ReinhardLenz/GyroVisor/images/circuit_image1.png

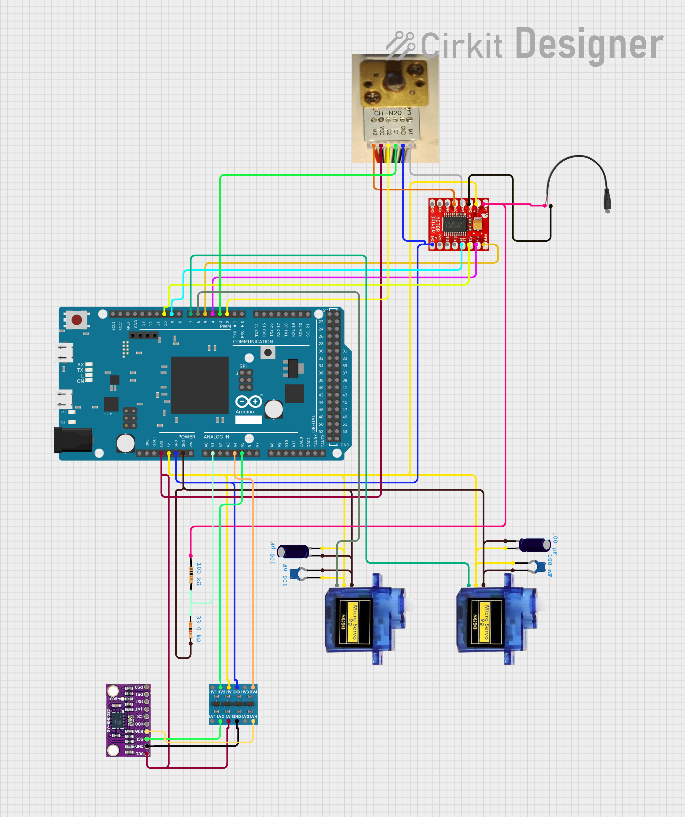
images/circuit_image1.png
