ReinhardLenz/GyroVisor/images/circuit_image_Seeeduino_XIAO.png

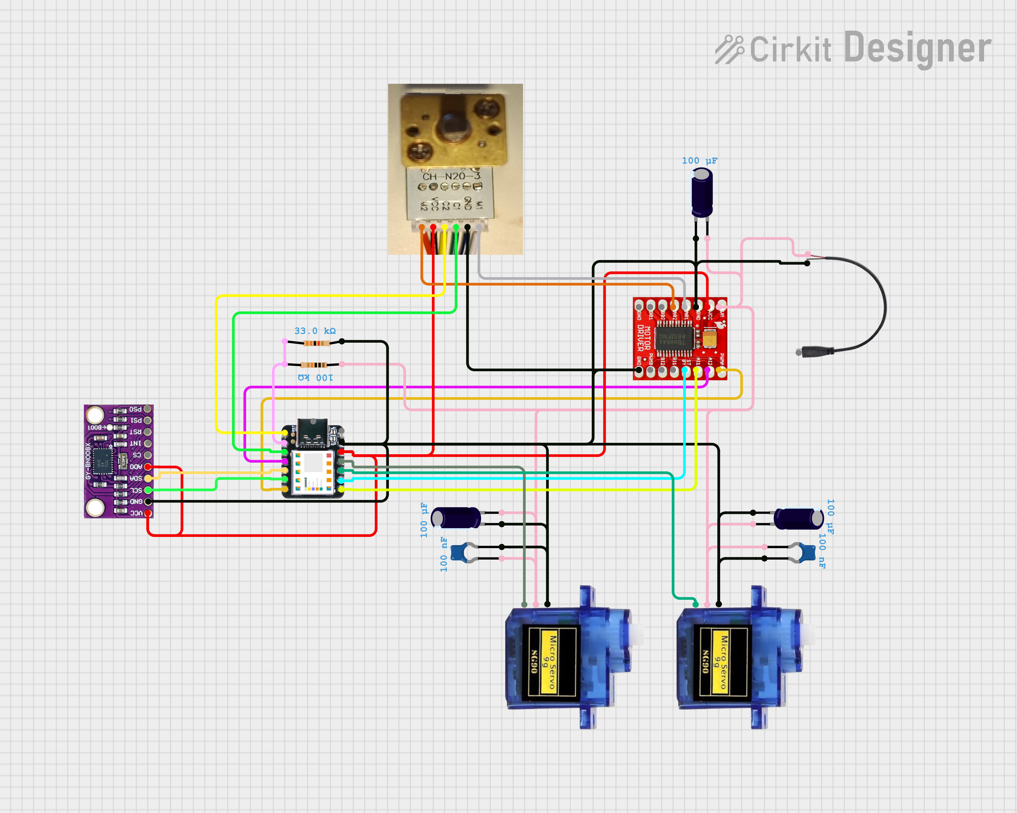
images/circuit_image_Seeeduino_XIAO.png
