ReinhardLenz/GyroVisor/images/error_time_protocol.png

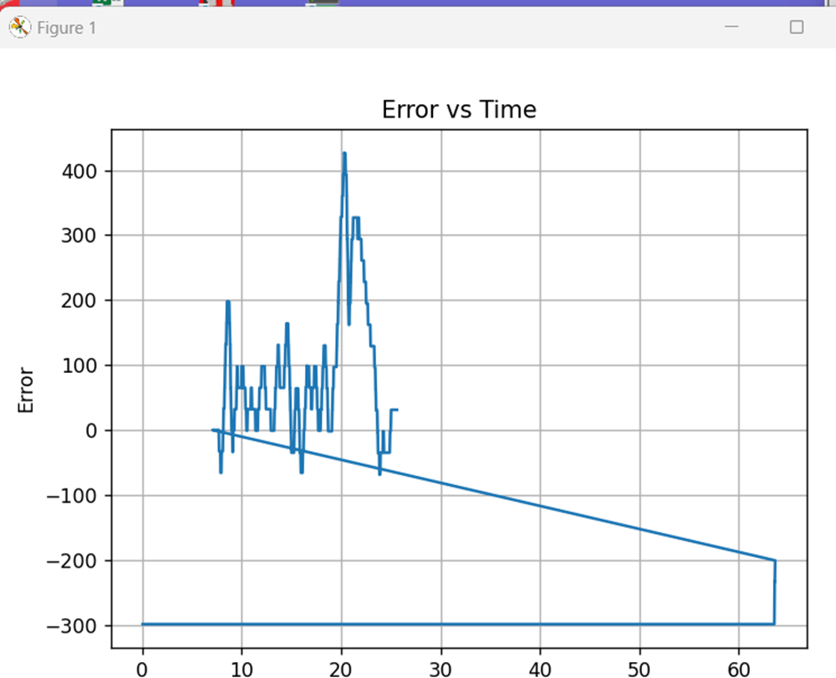
images/error_time_protocol.png
