ReinhardLenz/GyroVisor/images/photo_BNO085_gyrovisor.jpg

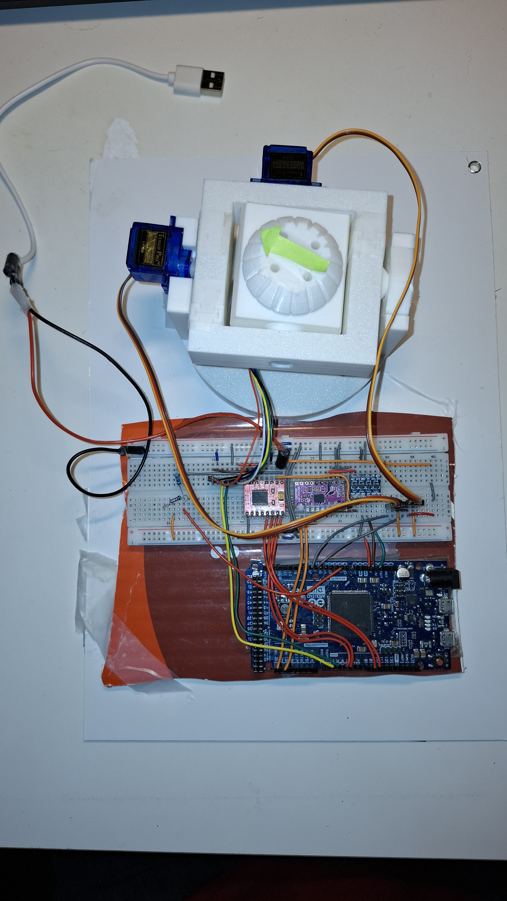
images/photo_BNO085_gyrovisor.jpg
