ReinhardLenz/GyroVisor/measure_error_time_protocol_2nd.txt

t=59.44s error=-2039.0
t=59.44s error=-2030.0
t=59.45s error=-2011.0
t=59.48s error=-2048.0
t=59.49s error=-2039.0
t=59.49s error=-2029.0
t=59.52s error=-2105.0
t=59.53s error=-2096.0
t=59.53s error=-2086.0
t=59.55s error=-2065.0
t=59.58s error=-2100.0
t=59.59s error=-2090.0
t=59.59s error=-2081.0
t=59.60s error=-2062.0
t=59.63s error=-2097.0
t=59.64s error=-2087.0
t=59.64s error=-2077.0
t=59.67s error=-2153.0
t=59.68s error=-2143.0
t=59.69s error=-2133.0
t=59.69s error=-2113.0
t=59.73s error=-2182.0
t=59.73s error=-2172.0
t=59.74s error=-2162.0
t=59.75s error=-2143.0
t=59.78s error=-2212.0
t=59.79s error=-2202.0
t=59.79s error=-2193.0
t=59.82s error=-2266.0
t=59.83s error=-2257.0
t=59.83s error=-2246.0
t=59.84s error=-2226.0
t=59.88s error=-2291.0
t=59.88s error=-2281.0
t=59.89s error=-2271.0
t=59.90s error=-2249.0
t=59.93s error=-2280.0
t=59.94s error=-2269.0
t=59.94s error=-2259.0
t=59.95s error=-2237.0
t=59.98s error=-2264.0
t=59.99s error=-2253.0
t=59.99s error=-2243.0
t=60.03s error=-2313.0
t=60.03s error=-2303.0
t=60.04s error=-2292.0
t=60.05s error=-2270.0
t=60.08s error=-2299.0
t=60.09s error=-2289.0
t=60.09s error=-2278.0
t=60.10s error=-2256.0
t=60.13s error=-2319.0
t=60.14s error=-2309.0
t=60.14s error=-2298.0
t=60.17s error=-2367.0
t=60.18s error=-2356.0
t=60.18s error=-2345.0
t=60.20s error=-2321.0
t=60.23s error=-2380.0
t=60.23s error=-2370.0
t=60.24s error=-2358.0
t=60.25s error=-2334.0
t=60.28s error=-2392.0
t=60.29s error=-2381.0
t=60.29s error=-2370.0
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
t=72.02s error=326.0
t=72.06s error=320.0
t=72.06s error=319.0
t=72.06s error=319.0
t=72.07s error=318.0
t=72.10s error=313.0
t=72.11s error=312.0
t=72.11s error=312.0
t=72.11s error=312.0
t=72.13s error=311.0
t=72.16s error=307.0
Stopped.

Integral of Absolute Error (IAE): 83891.95
