ReinhardLenz/GyroVisor/src/main.cpp

#include <Arduino.h>
#include <SparkFun_BNO08x_Arduino_Library.h>
#include <Encoder.h>
#include "Compass.h"
#include <Wire.h>
#include <Servo.h>

#define BNO08X_RESET -1
#define TIMEOUT_BOOT_BNO 100
#define BNO08X_I2C_ADDRESS 0x4B

//const int alwaysOnButtonPin = A0;
unsigned long millisOld;
const unsigned long vibrationDurationMillis = 200UL;
const unsigned long vibrationIntervalMillis = 1000UL;
const unsigned long serialKeepDurationMillis = 10UL * 1000UL;


//const int PIN_SDA = A4;   // works on many cores; otherwise set explicit pin numbers
//const int PIN_SCL = A5;

static uint32_t lastGoodEventMs = 0;
static uint32_t bootMs = 0;
static uint32_t lastRecoverAttemptMs = 0;

// Tune these:
const uint32_t STARTUP_GRACE_MS = 3000;          // wait after setup before any recovery
const uint32_t NO_EVENT_BEFORE_RECOVER_MS = 4000; // must be "dead" this long before recovery
const uint32_t RECOVER_COOLDOWN_MS = 5000;        // minimum time between recovery attempts

int degree_shift;
long lastSerialRecv = -10000L;
float lastSerialHeading = 0.0f;


Compass compass;
BNO08x imu;

#define DBG_PRINTLN(x) do { if (Serial) Serial.println(x); } while(0)
#define DBG_PRINT(x)   do { if (Serial) Serial.print(x); } while(0)


// --------------------- TB6612 Motor Driver ---------------------
const int pwmA = 3; // pin for motor A PWM speed control
const int in1A = 10; // pin for motor AI1 direction control
const int in2A = 9; // pin for motor AI2 direction control
const int stby = 0; // pin for motor driver standby (active HIGH)
const int Servo_pitch = 6; // pin for servo control
const int Servo_roll = 7; // pin for servo control



// --------------------- VM Sensing ---------------------
#define VM_SENSE 8  // ADC pin for sensing motor supply voltage (VM). Connect a voltage divider from VM to this pin, with the midpoint going to the ADC pin and the bottom resistor to GND. The top resistor goes to VM. For example, a 56kΩ bottom resistor and 100kΩ top resistor gives a ~1.785 divider, so 12V on VM would read about 6.7V at the ADC pin, which is above the 5V max ADC input but we will just treat it as "over threshold". Adjust the threshold accordingly.
//const float VM_DIVIDER = 1.785;   // 100k / 56k divider
const float VM_THRESHOLD = 4.9;  // volts

// --------------------- Encoder ---------------------
//Encoder enc(1, 2); // pins for encoder input (A, B)

// --------------------- Control Parameters ---------------------
const int DEADZONE = 100;   // encoder counts tolerance
const long SCALE_DEG_TO_ENC = 33L;  
// ~12 counts per pot unit = ~12000 counts full-scale for 1023 pot units.
// 12000 counts / 360° ≈ 33 counts per degree.

// --------------------- Compass ---------------------
float heading = 0.0;
float roll = 0.0;
float pitch= 0.0;
// --------------------- Runtime Variables ---------------------
long targetEnc = 0;
long currentEnc = 0;
long error = 0;
float lastHeading = 0.0;
float continuousHeading = 0.0;

Servo servo_pitch;
Servo servo_roll;

float prevRoll = 0.0f;
float prevPitch = 0.0f;
static unsigned long lastServo = 0;

//PID control  variables
float Kd = 0.00;
const float Kp = 0.02;     // proportional gain

// PID state variables
float integral = 0;
float lastError = 0;
unsigned long lastTime = 0;
const int MIN_PWM = 40; 

static uint32_t lastEncoderChange = 0;
static long prevEnc = 0;


// --------------------- Helper Functions ---------------------
float readVmVoltage() {
  int raw = analogRead(VM_SENSE);
  float vin = raw * (5.0 / 1023.0);
  return vin;
}


volatile long encoderCount = 0;

const int encoderA = 1;
const int encoderB = 2;

void encoderISR() {

    if (digitalRead(encoderB))
        encoderCount++;
    else
        encoderCount--;
}


// Simple function to blink the built-in LED n times (for error indication)
void blinkCode(int n) {
  for (int i = 0; i < n; i++) {
    digitalWrite(LED_BUILTIN, HIGH); delay(150);
    digitalWrite(LED_BUILTIN, LOW);  delay(150);
  }
  delay(600);
}


// --------------------- Setup ---------------------
void setup() {

  pinMode(LED_BUILTIN, OUTPUT);
  // Motor control pins
  pinMode(pwmA, OUTPUT);
  pinMode(in1A, OUTPUT);
  pinMode(in2A, OUTPUT);
  pinMode(stby, OUTPUT);
  digitalWrite(stby, LOW);
  //Servo initialization
  servo_pitch.attach(Servo_pitch);
  servo_roll.attach(Servo_roll);
  delay(2000);  // give bootloader time to enumerate
  
pinMode(encoderA, INPUT_PULLUP);
pinMode(encoderB, INPUT_PULLUP);

attachInterrupt(
    digitalPinToInterrupt(encoderA),
    encoderISR,
    RISING
);

  
  blinkCode(1);  // reached setup start
  Serial.begin(9600);
  blinkCode(2);  // reached setup start

  Wire.begin();
  blinkCode(3);  // reached setup start
  
  


  Wire.setClock(400000);
  delay(300);   // IMPORTANT: let BNO085 boot 
  // Initialize IMU

// Start communication with BNO085

  int retries = 0;
  while (!imu.begin() && retries < 10) {
    blinkCode(9); // IMU begin retry marker
    delay(500);
    retries++;
  }
  blinkCode(4);  // after imu.begin loop

  if (!imu.enableGameRotationVector(1000)) {
    blinkCode(7); // enable report failed
  } else {
    blinkCode(5); // enabled ok
  }
    delay(1000);
  }

// --------------------- Main Loop ---------------------
void loop() {
static bool t = false;
t = !t;
digitalWrite(LED_BUILTIN, t);

float vm = readVmVoltage();

if (vm > VM_THRESHOLD) {
  digitalWrite(stby, HIGH); // enable motor driver
  //    heading = compass.getHeading(degree_shift);   // 0–360°
  bool gotEvent = imu.getSensorEvent();
  if (gotEvent) {
    // Push the new event into Compass
    compass.updateFromSensor(imu.sensorValue);
    // Compute heading once for this event, using the latest degree_shift
    heading = compass.getHeading(degree_shift);
    lastGoodEventMs = millis();
  } else {
    // Optional 1s heartbeat
    static uint32_t lastPrintMs = 0;
    if (millis() - lastPrintMs > 1000) {
      //Serial.println("No sensor event (not necessarily an error)");
      lastPrintMs = millis();
      }
  }
  
  // --- Compute continuous heading to avoid 0°↔360° jumps ---
  float delta = heading - lastHeading;
  // Handle wrap-around crossing (e.g., 359° → 1° gives delta = -358°, fix it)
  if (delta > 180.0) delta -= 360.0;
  else if (delta < -180.0) delta += 360.0;
  continuousHeading += delta; //continuousHeading can grow beyond 0–360° (e.g. −720°, +1440°, etc.) It represents how much total rotation has occurred.
  // --- Convert continuous heading → target encoder counts ---
  targetEnc = (long)(continuousHeading * SCALE_DEG_TO_ENC); // also targetEnc can grow beyond 11880 or lelow -11880
//  DBG_PRINT("H:");
//  DBG_PRINT(targetEnc);

  static uint32_t lastEncRead = 0;

  currentEnc = encoderCount;
  
  // --- Compute control error ---
  error = targetEnc-currentEnc;

  long absErr = abs(error);

  // --- PID output ---
  unsigned long now = millis();
  float dt = (now - lastTime) / 1000.0;

  float derivative = 0;

  if (dt > 0)
      derivative = (error - lastError) / dt;

  float output = Kp * error + Kd * derivative;

  lastError = error;
  lastTime = now;



  // Convert to PWM
  int pwm = abs((int)output);
  

  
  if (absErr > 500 && pwm < MIN_PWM) {
    pwm = MIN_PWM;
  }

  if (pwm > 255) pwm = 255;
  // --- Control motor direction ---
  if (absErr <= DEADZONE) {  //if it is already close enough
    analogWrite(pwmA, 0); // stop motor
    digitalWrite(in1A, LOW);
    digitalWrite(in2A, LOW);
  } else if (output > 0) {     // moto
    digitalWrite(in1A, HIGH);
    digitalWrite(in2A, LOW);
    analogWrite(pwmA, pwm);

  } else {
    digitalWrite(in1A, LOW);
    digitalWrite(in2A, HIGH);
    analogWrite(pwmA, pwm);

  }

  } else {
    // VM below threshold → disable motor driver
    digitalWrite(stby, LOW);
    analogWrite(pwmA, 0);

}



if (millis() - lastServo > 20) {

  lastServo = millis();

  roll = compass.getRoll();
 servo_roll.write((int)(90 - roll));

  pitch = compass.getPitch();
  servo_pitch.write((int)(90 + pitch));
}



if (currentEnc != prevEnc) {
    lastEncoderChange = millis();
    prevEnc = currentEnc;
}

static long prevEnc = 0;

if (currentEnc != prevEnc) {
    lastEncoderChange = millis();
    prevEnc = currentEnc;
}

if (abs(error) > 2000 &&
    (int) (pwm) > 180 &&
    millis() - lastEncoderChange > 1000) {

    Serial.println("OUTPUT SYSTEM FROZEN");

    // full peripheral recovery
    servo_pitch.detach();
    servo_roll.detach();

    analogWrite(pwmA , 0);

    delay(50);

    servo_pitch.attach(Servo_pitch);
    servo_roll.attach(Servo_roll);

    analogWrite(pwmA, (int)(pwm));

    delay(50);
}


lastHeading = heading;
// heartbeat LED to indicate loop is alive 
digitalWrite(LED_BUILTIN, millis() % 1000 < 500);
}
