ReinhardLenz/GyroVisor/src/imu_visualizer.py

#from ursina import *
#from ursina import Ursina, color, Entity, DirectionalLight, Text, AmbientLight, EditorCamera, Vec3
from ursina import Ursina, color, Entity, DirectionalLight, Text, AmbientLight, EditorCamera, Vec3
from serial import Serial, SerialException
# Set up serial connection
try:
    serialPort = Serial(port="COM13", baudrate=9600, timeout=0.5)
except SerialException:
    print("Could not open serial port. Please check the port name and your permissions.")
    exit()
# Initialize the Ursina engine
app = Ursina()
app.background_color = color.rgb(0, 0, 255)  # Set background to blue
# Create a red cuboid
cuboid = Entity(
    model='cube',
    color=color.red,
    scale=(4, .5, 2)
)

LINE_LENGTH = 0.2
LINE_THICKNESS = 0.02
# Define the function to create a line entity
def create_line(length, thickness, color, position):
    return Entity(
        model='cube',
        scale=(length, thickness, thickness) if length > thickness else (thickness, length, thickness),
        color=color,
        position=position
    )

def setup_lighting():
    # Create a directional light
    directional_light = DirectionalLight()
    directional_light.look_at(Vec3(1, -1, -1))  # Direction the light is pointing towards
    directional_light.cast_shadow = True  # Enable casting shadows
    # Further configurations if you want to customize the light
    directional_light.shadow_map_size = 2048  # Higher values give better shadow resolution
    directional_light.falloff = 10  # Controls the light's attenuation
    directional_light.color = color.white

nw_text = None
def add_text_to_scene(text_string, x_position, y_position):
    global nw_text
    # If nw_text is None, this is the first time setting the text
    if nw_text is None:
        nw_text = Text(
            text=text_string,  # The text you want to display
            position=(x_position, y_position)  # The screen position for the text
        )
    else:
        # Update the text of the existing Text entity
        nw_text.text = text_string
def update():
    global nw_text
    if serialPort.inWaiting() > 0:
        data_bytes = serialPort.readline()
        try:
            data_str = data_bytes.decode('utf-8', errors='replace').strip()
            print(data_str)
            data_parts = data_str.split()
            # Check if all parts are present
            if len(data_parts) >= 3 and data_parts[0] == "X:" and data_parts[2] == "Y:" and data_parts[4] == "Z:":
                x = float(data_parts[1])  # X value
                y = float(data_parts[3])  # Y value
                z = float(data_parts[5])  # Z value

                # Update cuboid's rotation
                cuboid.rotation_x = -z % 360
                cuboid.rotation_y = -x % 360
                cuboid.rotation_z = y % 360
                
            else:
                print(f"Incomplete or incorrect data received: {data_str}")
        except ValueError as e:
            print(f"Error parsing data: {e}")
            pass# Set the update function to be called every frame



def start():
    #app = Ursina()

    # Set up the scene with lighting
    setup_lighting()
    # Create a red cuboid

    ground = Entity(
        model='plane',
        scale=(10, 10, 10),
        color=color.gray,
        position=(0, -0.1, 0),
        receive_shadow=True
    )
   
       # Create a line from (0,0,0) to (LX,0,0)
    LX = 5  # Half of the ground plane's scale along the X-axis
    line = Entity(
        model='cube',
        scale=(LX, 0.05, 0.05),  # Thin cube to look like a line
        color=color.white,
        position=(LX / 2, 0, 0)  # Centered between the two points
    )
    line = Entity(
        model='cube',
        scale=(0.05, LX, 0.05),  # Thin cube to look like a line
        color=color.white,
        position=(0, LX / 2, 0)  # Centered between the two points
    )
    
    
    line = Entity(
        model='cube',
        scale=(0.05, 0.05, LX),  # Thin cube to look like a line
        color=color.white,
        position=(0, 0 , LX / 2)  # Centered between the two points
    )
    x_line = create_line(LINE_LENGTH, LINE_THICKNESS, color.red, (LX*1.1, 0, 0))
    # Create two small lines for Y at coordinate (0.0, LY, 0.0)
    LY = 1.0  # The position to place the lines
    y_line_1 = create_line(LINE_LENGTH, LINE_THICKNESS, color.green, (0, LY*1.1, LINE_LENGTH))
    y_line_2 = create_line(LINE_LENGTH, LINE_THICKNESS, color.green, (0, LY*1.1, -LINE_LENGTH))
    # Create three small parallel lines for Z at coordinate (0.0, 0.0, LZ)
    LZ = 2.0  # The position to place the lines
    z_line_1 = create_line(LINE_LENGTH, LINE_THICKNESS, color.blue, (0, 0, LZ))
    z_line_2 = create_line(LINE_LENGTH, LINE_THICKNESS, color.blue, (0, 0.1, LZ))
    z_line_3 = create_line(LINE_LENGTH, LINE_THICKNESS, color.blue, (0, 0.2, LZ))
# Setup camera to see the markers
    # Example to add ambient light to the scene
    AmbientLight(color=color.rgba(100, 100, 100, 100))
    EditorCamera()
    app.run()
if __name__ == '__main__':
    start()
