ReinhardLenz/GyroVisor/(commit log)

2025-11-28 Enhance README with circuit documentation
    Added detailed circuit documentation including component descriptions and wiring details.
2025-11-28 Update README with detailed circuit documentation
    Expanded the component list and wiring details for the motor control circuit.
2026-02-04 Update README with circuit diagram and 3D view
    Added circuit diagram and 3D view images to README.
2026-03-06 Update README with STL parts and images
    Added links to STL parts and images of the GyroVisor.
2026-03-11 Update README with component descriptions and images
    Added descriptions, pins, and images for various components including TB6612FNG Motor Driver, Motor N20 with Encoder, USB C to 2 fils, BNO055, Micro Servo 9G, and Adafruit PCA9685 PWM Servo Breakout.
2026-03-20 Enhance README with detailed project description
    Expanded description of the GyroVisor project, detailing its components and functionality.
2026-04-05 Enhance README with shopping links and detailed code docs
    Added a section for shopping list links and expanded code documentation with detailed explanations of the Arduino Due functionality, Compass class, and libraries used.
2026-04-07 changed input pins for the servos from analog input side to PWM digital side
2026-04-07 added capacitors, changed pins
    Updated the circuit diagram image in the README.
2026-04-07 potentiometer deleted
    Removed detailed component list and wiring details from the README, focusing on code documentation and circuit overview.
2026-04-07 Clean up wiring instructions in README
    Removed detailed wiring instructions for various components including the trimmer potentiometer, motor driver, and servos.
2026-04-10 PID control
2026-05-13 changed pins because the TB6612 and servos don't work simultaneously
2026-05-14 changes PWMA=3,IN1A=10, IN2A=9, stby=0, VM=8, pitch=6, roll=7)
2026-05-18 encoder counting principle without library
2026-05-18 changes to README updated circuit, pin connections
